HUANsic/ICAR_Hover2024/CH32Code/iomap.pptx

CH32V307

## Slide 2

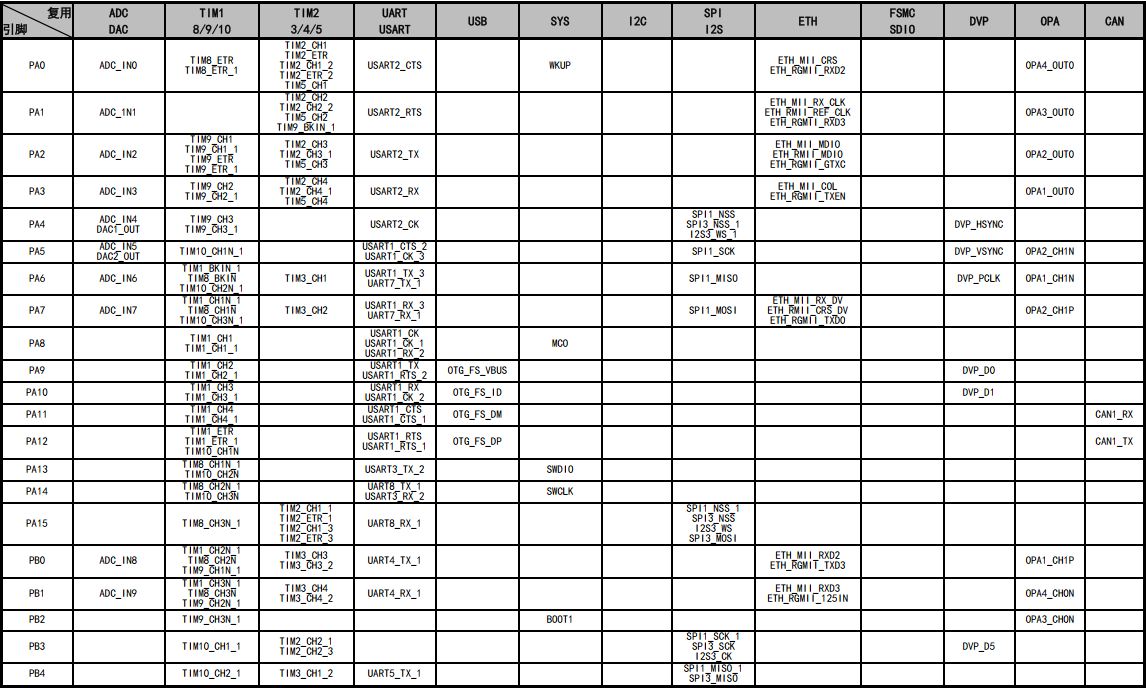
[picture p1: figure]

## Slide 3

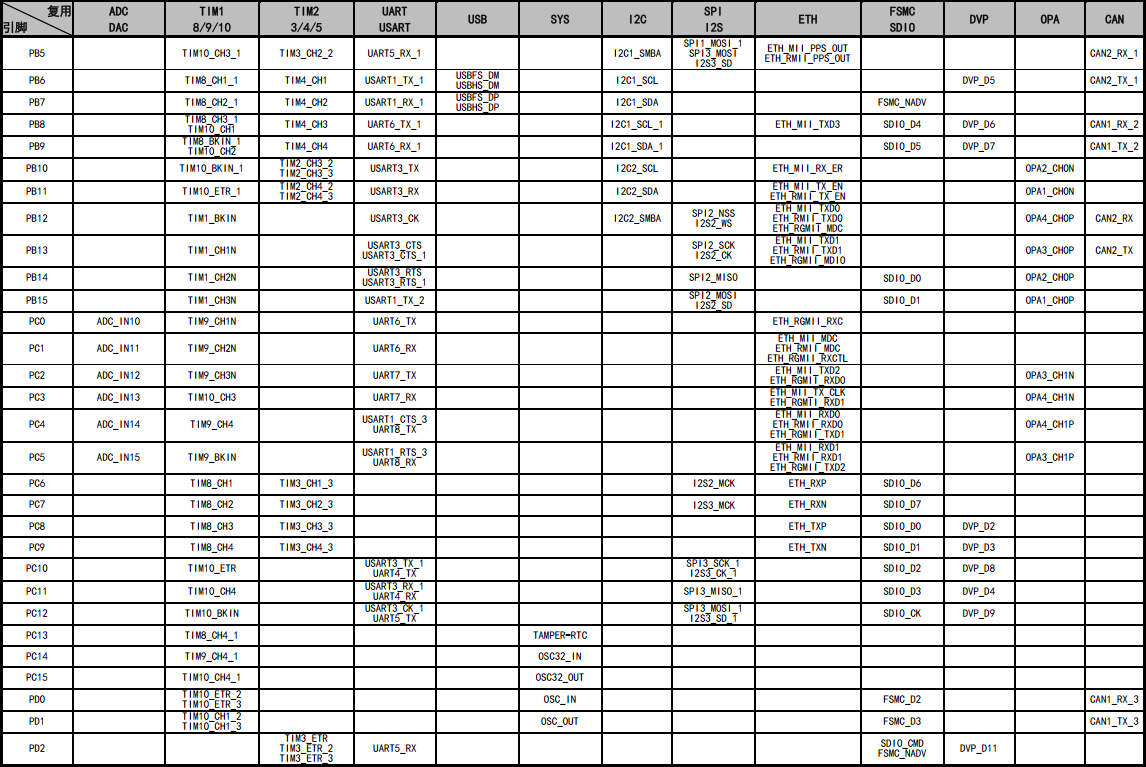
[picture p2: figure]

## Slide 4

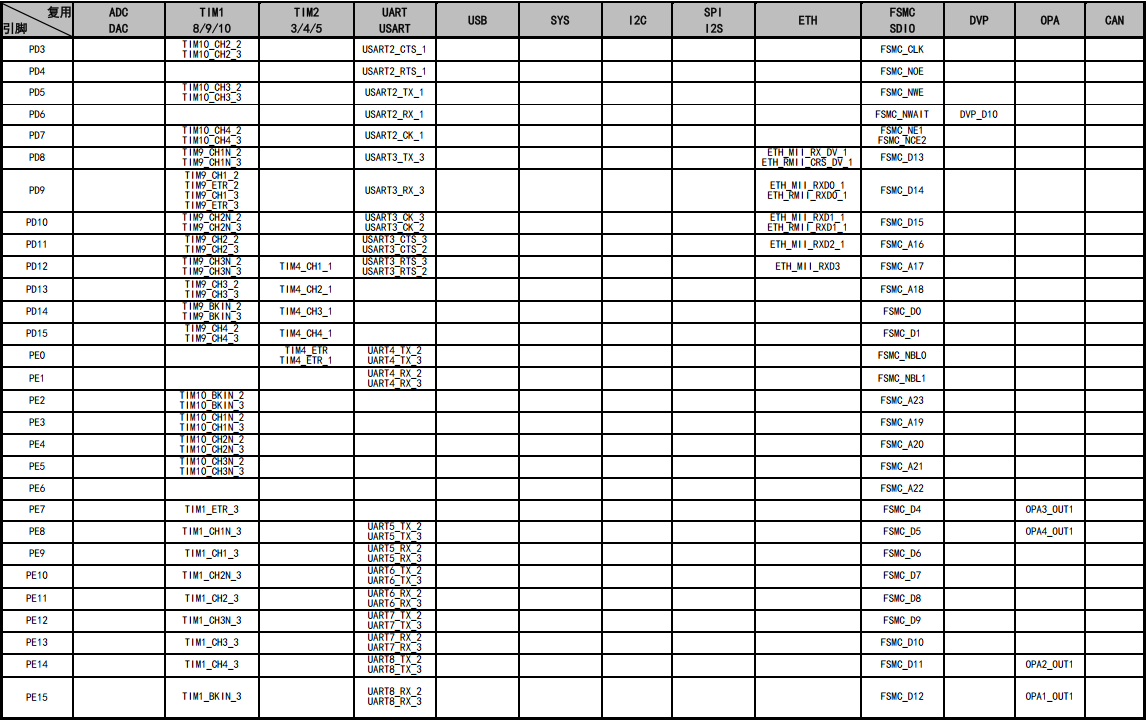
[picture p3: figure]

## Slide 5

CH32V203

## Slide 6

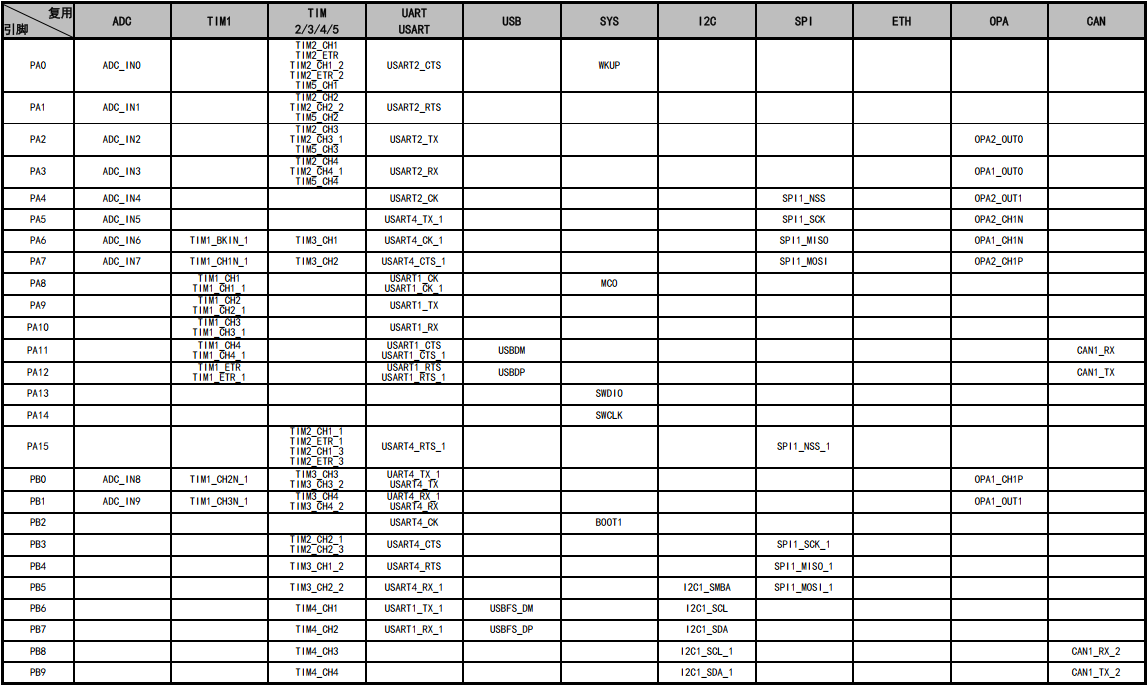
[picture p4: figure]

## Slide 7

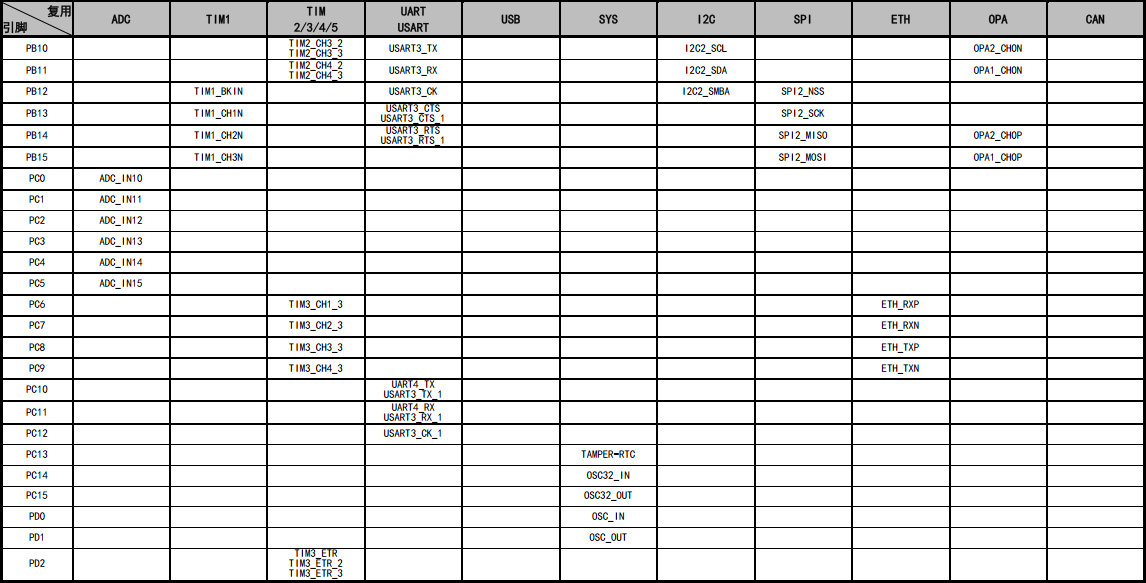
[picture p5: figure]

## Slide 8
