HUANsic/ICAR_Hover2024/PCB/version3/嘉立创SMT订单核对_Gerber_Main_v3_2024-07-28_2024-7-28.pdf

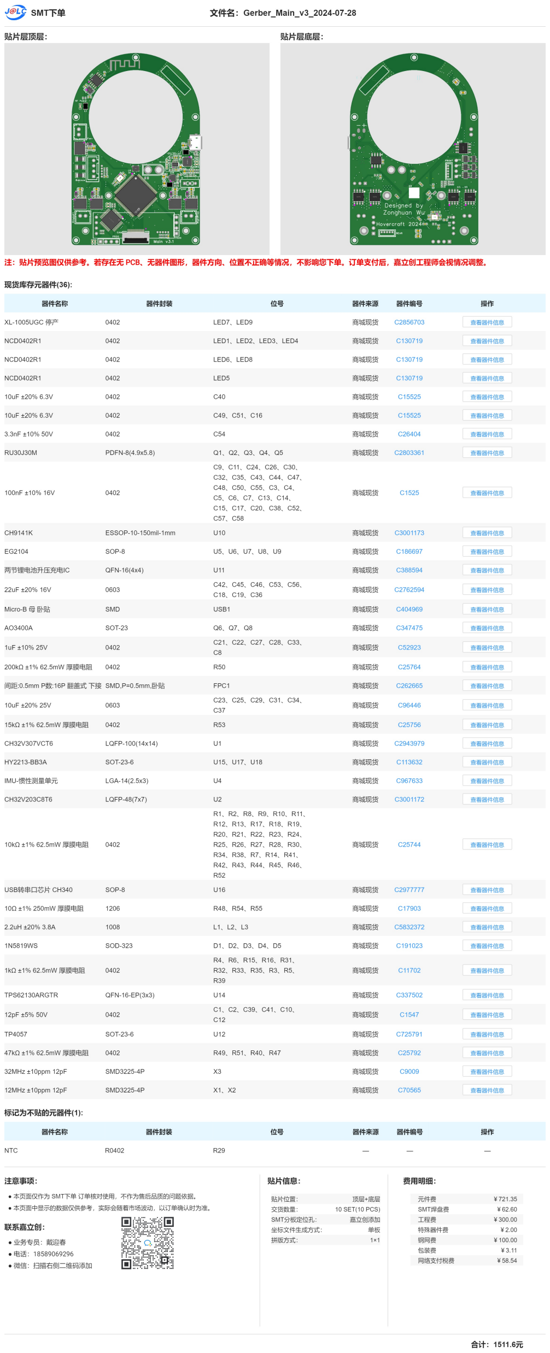
[picture p6: page 1]
