HUANsic/ICAR_Hover2024/PCB/version3/BOM_Main_v3_Main_v3_2024-07-28.xlsx

No. | Quantity | Comment | Designator | Footprint | Value | Manufacturer Part | Manufacturer | Supplier Part | Supplier
1 | 6 | 12pF | C1,C2,C10,C12,C39,C41 | C0402 | 12pF | 0402CG120J500NT | FH(风华) | C1547 | LCSC
2 | 27 | 100nF | C3,C4,C5,C6,C7,C9,C11,C13,C14,C15,C17,C20,C24,C26,C30,C32,C35,C38,C43,C44,C47,C48,C50,C52,C55,C57,C58 | C0402 | 100nF | CL05B104KO5NNNC | SAMSUNG(三星) | C1525 | LCSC
3 | 6 | 1uF | C8,C21,C22,C27,C28,C33 | C0402 | 1uF | CL05A105KA5NQNC | SAMSUNG(三星) | C52923 | LCSC
4 | 3 | 10uF | C16,C49,C51 | C0402 | 10uF | CL05A106MQ5NUNC | SAMSUNG(三星) | C15525 | LCSC
5 | 8 | 22uF | C18,C19,C36,C42,C45,C46,C53,C56 | C0603 | 22uF | CL10A226MO7JZNC | SAMSUNG(三星) | C2762594 | LCSC
6 | 6 | 10uF | C23,C25,C29,C31,C34,C37 | C0603 | 10uF | CL10A106MA8NRNC | SAMSUNG(三星) | C96446 | LCSC
7 | 1 | 2.2uF | C40 | C0402 | 2.2uF | CL05A225MQ5NSNC | SAMSUNG(三星) | C12530 | LCSC
8 | 1 | 3.3nF | C54 | C0402 | 3.3nF | CL05B332KB5NNNC | SAMSUNG(三星) | C26404 | LCSC
9 | 5 | 1N5819WS | D1,D2,D3,D4,D5 | SOD-323_L1.8-W1.3-LS2.5-RD |  | 1N5819WS | Hottech(合科泰) | C191023 | LCSC
10 | 1 | CAM | FPC1 | FPC-SMD_P0.50-16P_FGS-XJ-H2.0 |  | AFC01-S16FCA-00 | JS(钜硕电子) | C262665 | LCSC
11 | 3 | 2.2uH | L1,L2,L3 | IND-SMD_L2.5-W2.0_MHCHL2520 | 2.2uH | FTC252012S2R2MBCA | cjiang(长江微电) | C5832372 | LCSC
12 | 4 | NCD0402R1 | LED1,LED2,LED3,LED4 | LED0402-RD |  | NCD0402R1 | 国星光电 | C130719 | LCSC
13 | 1 | RF Power | LED5 | LED0402-R-RD_RED |  | XL-1005SURC | XINGLIGHT(成兴光) | C965790 | LCSC
14 | 2 | CHRG | LED6,LED8 | LED0402-RD |  | NCD0402R1 | 国星光电 | C130719 | LCSC
15 | 2 | STBY | LED7,LED9 | LED0402-RD_GREEN |  | XL-1005UGC | XINGLIGHT(成兴光) | C2856703 | LCSC
16 | 5 | RU30J30M | Q1,Q2,Q3,Q4,Q5 | PDFN-8_L5.8-W4.9_RU30J30M |  | RU30J30M | Ruichips(锐骏半导体) | C2803361 | LCSC
17 | 3 | AO3400A | Q6,Q7,Q8 | SOT-23-3_L2.9-W1.3-P1.90-LS2.4-BR |  | AO3400A | UMW(友台半导体) | C347475 | LCSC
18 | 32 | 10kΩ | R1,R2,R7,R8,R9,R10,R11,R12,R13,R14,R17,R18,R19,R20,R21,R22,R23,R24,R25,R26,R27,R28,R30,R34,R38,R41,R42,R43,R44,R45,R46,R52 | R0402 | 10kΩ | 0402WGF1002TCE | UNI-ROYAL(厚声) | C25744 | LCSC
19 | 11 | 1kΩ | R3,R4,R5,R6,R15,R16,R31,R32,R33,R35,R39 | R0402 | 1kΩ | 0402WGF1001TCE | UNI-ROYAL(厚声) | C11702 | LCSC
20 | 1 | NTC | R29 | R0402 | NTCThermistor | NCP15XH103F03RC | muRata(村田) | C77131 | LCSC
21 | 4 | 47kΩ | R40,R47,R49,R51 | R0402 | 47kΩ | 0402WGF4702TCE | UNI-ROYAL(厚声) | C25792 | LCSC
22 | 3 | 10Ω | R48,R54,R55 | R1206 | 10Ω | 1206W4F100JT5E | UNI-ROYAL(厚声) | C17903 | LCSC
23 | 1 | 200kΩ | R50 | R0402 | 200kΩ | 0402WGF2003TCE | UNI-ROYAL(厚声) | C25764 | LCSC
24 | 1 | 15kΩ | R53 | R0402 | 15kΩ | 0402WGF1502TCE | UNI-ROYAL(厚声) | C25756 | LCSC
25 | 1 | CH32V307VCT6 | U1 | LQFP-100_L14.0-W14.0-P0.50-LS16.0-BL |  | CH32V307VCT6 | WCH(南京沁恒) | C2943979 | LCSC
26 | 1 | CH32V203C8T6 | U2 | LQFP-48_L7.0-W7.0-P0.50-LS9.0-BL |  | CH32V203C8T6 | WCH(南京沁恒) | C3001172 | LCSC
27 | 1 | LSM6DS3TR-C | U4 | LGA-14_L3.0-W2.5-P0.50-TL |  | LSM6DS3TR-C | ST(意法半导体) | C967633 | LCSC
28 | 5 | EG2104 | U5,U6,U7,U8,U9 | SOP-8_L5.0-W4.0-P1.27-LS6.2-BL |  | EG2104 | EG(屹晶微) | C186697 | LCSC
29 | 1 | CH9141K | U10 | SSOP-10_L5.0-W3.9-P1.00-LS6.0-BL-EP |  | CH9141K | WCH(南京沁恒) | C3001173 | LCSC
30 | 1 | SLM6800 | U11 | VQFN-16_L4.0-W4.0-P0.65-TL-EP2.2 |  | SLM6800 | 无锡松朗微 | C388594 | LCSC
31 | 1 | TP4057 | U12 | SOT-23-6_L2.9-W1.6-P0.95-LS2.8-BR |  | TP4057 | UMW(友台半导体) | C725791 | LCSC
32 | 1 | TPS62130ARGTR | U14 | VQFN-16_L3.0-W3.0-P0.50-BL-EP1.7 |  | TPS62130ARGTR | TI(德州仪器) | C337502 | LCSC
33 | 3 | HY2213-BB3A | U15,U17,U18 | SOT-23-6_L2.9-W1.6-P0.95-LS2.8-BR |  | HY2213-BB3A | HYCON(宏康) | C113632 | LCSC
34 | 1 | CH340N | U16 | SOP-8_L4.9-W3.9-P1.27-LS6.0-BL |  | CH340N | WCH(南京沁恒) | C2977777 | LCSC
35 | 1 | MicroXNJ | USB1 | MICRO-USB-SMD_MICROXNJ |  | MicroXNJ | SHOU HAN(首韩) | C404969 | LCSC
36 | 2 | 12MHz | X1,X2 | OSC-SMD_4P-L3.2-W2.5-BL | 12MHz | X322512MOB4SI | YXC(扬兴晶振) | C70565 | LCSC
37 | 1 | 32MHz | X3 | CRYSTAL-SMD_4P-L3.2-W2.5-BL | 32MHz | X322532MOB4SI | YXC(扬兴晶振) | C9009 | LCSC
