HUANsic/ICAR_Hover2024/Solidworks/version3/CameraBase_5.STL

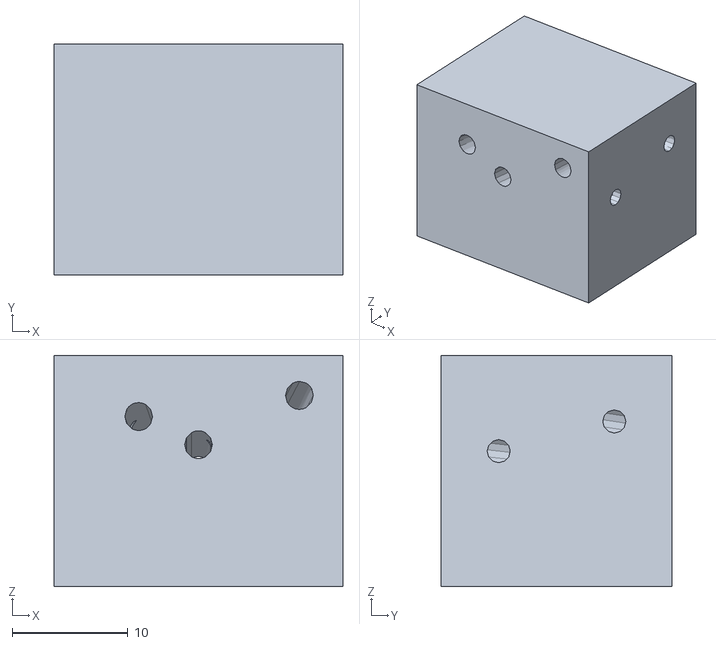
[picture p7: CAD file, 2024-08-02]
Solidworks/version3/CameraBase_5.STL
25.0 x 20.0 x 20.0
