HUANsic/ICAR_Hover2024/Solidworks/version3/CF_stick_2x1x300.SLDPRT

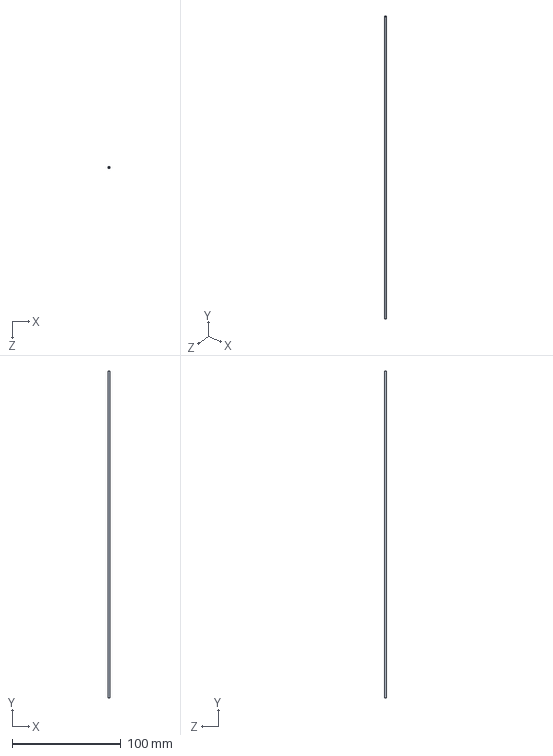
[picture p8: CAD file, 2024-08-02]
Solidworks/version3/CF_stick_2x1x300.SLDPRT
2.00 x 300.0 x 2.00 mm
