HUANsic/ICAR_Hover2024/Solidworks/version3/CameraClip_1mm.SLDPRT

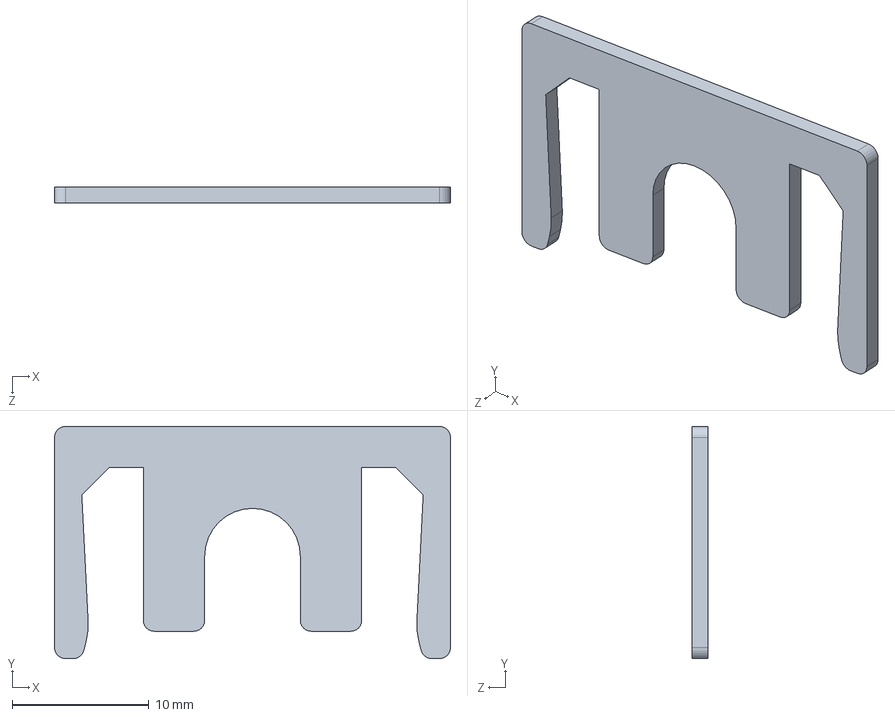
[picture p10: CAD file, 2024-08-02]
Solidworks/version3/CameraClip_1mm.SLDPRT
29.0 x 17.0 x 1.20 mm
