HUANsic/ICAR_Hover2024/Solidworks/version3/CameraBase_7.STL

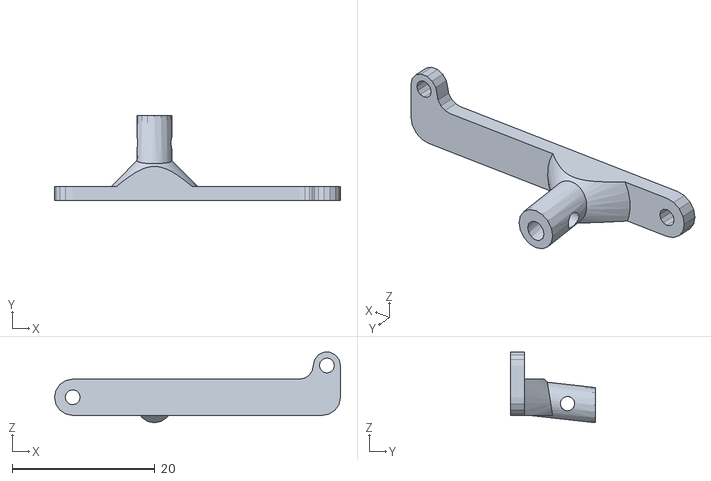
[picture p11: CAD file, 2024-08-02]
Solidworks/version3/CameraBase_7.STL
40.0 x 11.9 x 9.87
