HUANsic/ICAR_Hover2024/Solidworks/version3/propeller_1608.SLDPRT

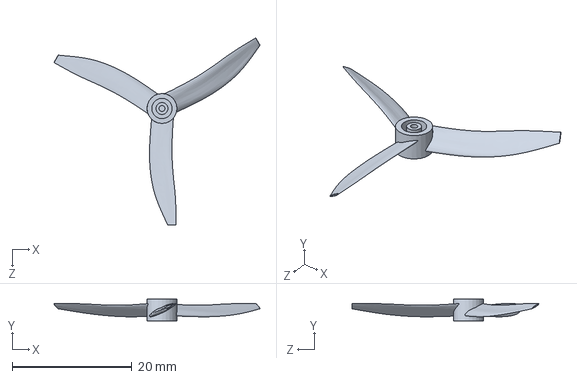
[picture p12: CAD file, 2024-08-02]
Solidworks/version3/propeller_1608.SLDPRT
34.5 x 3.60 x 31.3 mm
