HUANsic/ICAR_Hover2024/Solidworks/version3/CameraBase_6.STL

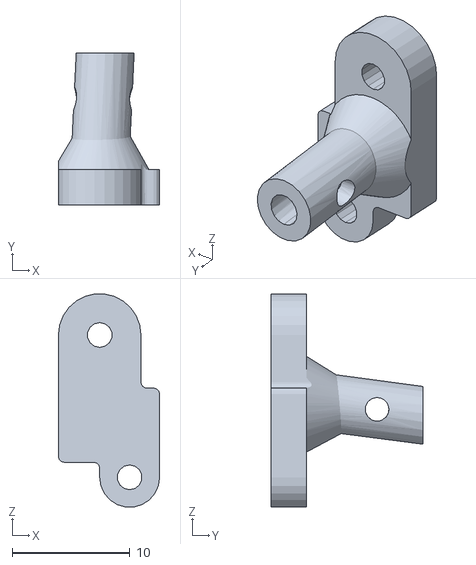
[picture p13: CAD file, 2024-08-02]
Solidworks/version3/CameraBase_6.STL
8.58 x 12.9 x 18.1
