HUANsic/ICAR_Hover2024/Solidworks/version3/PropHolder1.SLDPRT

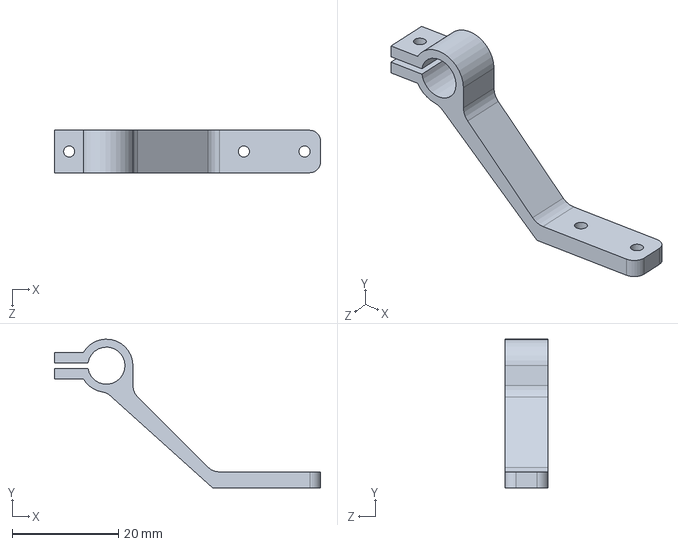
[picture p14: CAD file, 2024-08-02]
Solidworks/version3/PropHolder1.SLDPRT
50.1 x 28.0 x 8.00 mm
