HUANsic/ICAR_Hover2024/Solidworks/version3/CameraBase_4.STL

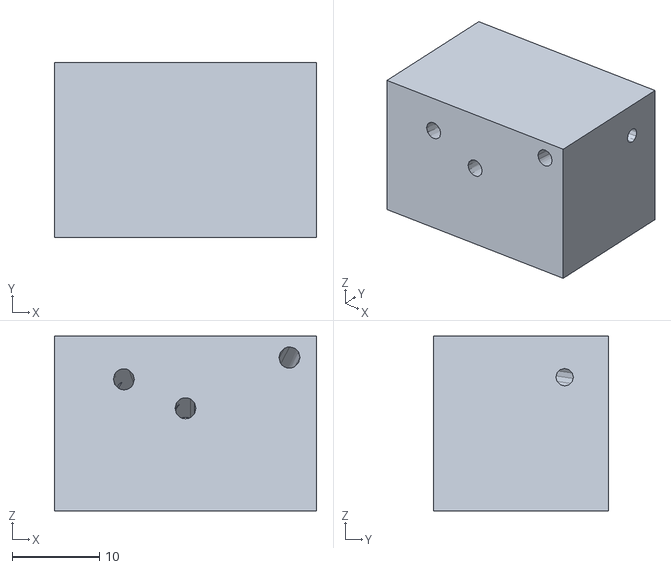
[picture p16: CAD file, 2024-08-02]
Solidworks/version3/CameraBase_4.STL
30.0 x 20.0 x 20.0
