HUANsic/ICAR_Hover2024/Solidworks/version3/CameraBase_9_w_clip.STL

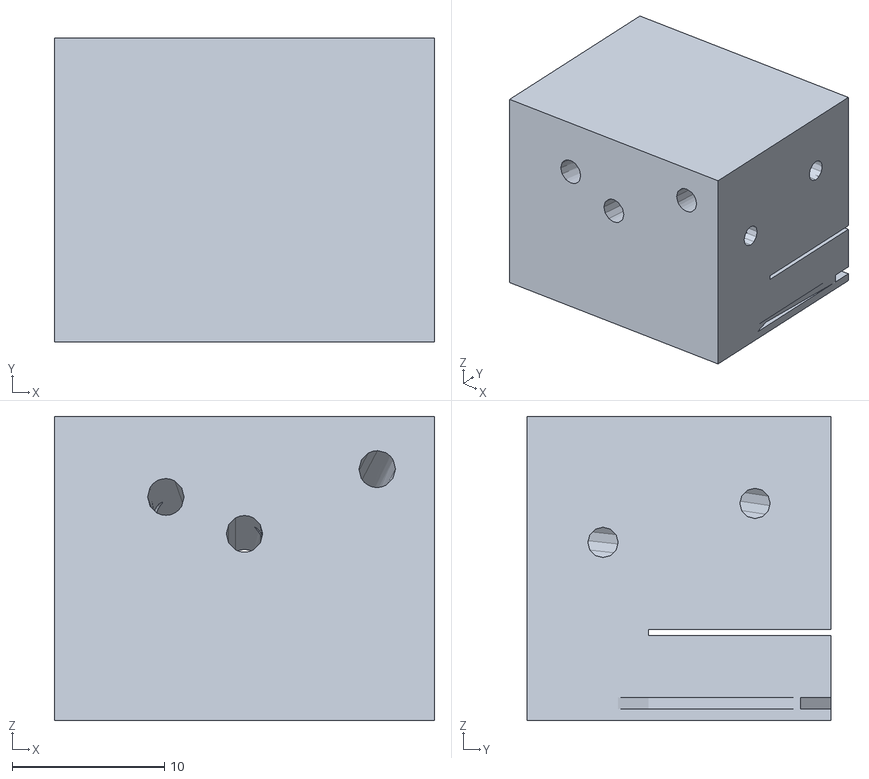
[picture p17: CAD file, 2024-08-02]
Solidworks/version3/CameraBase_9_w_clip.STL
25.0 x 20.0 x 20.0
