HUANsic/ICAR_Hover2024/Solidworks/version3/CameraBase_8.STL

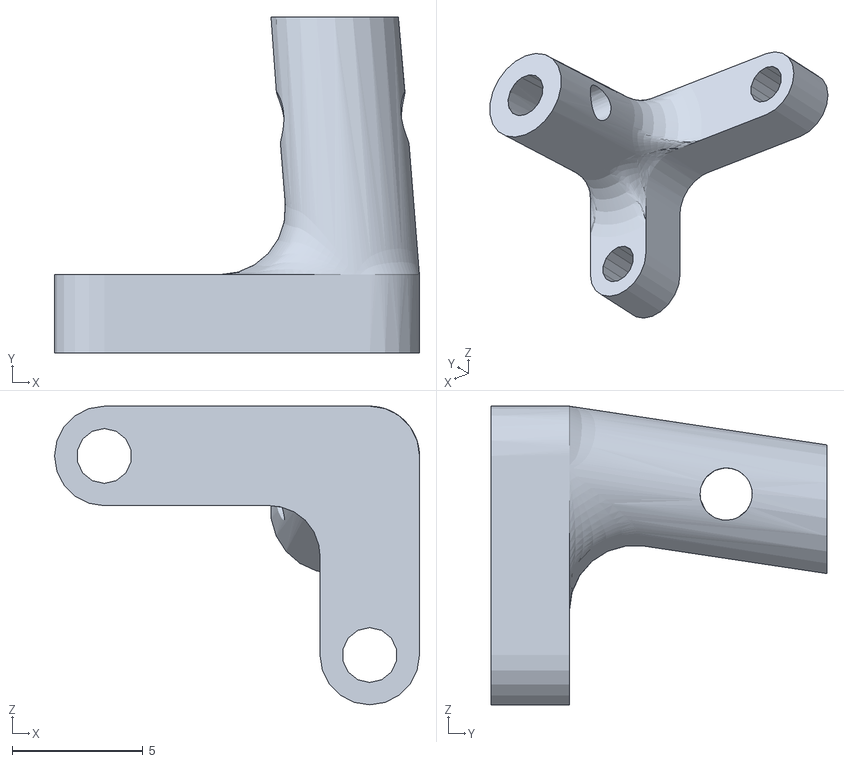
[picture p18: CAD file, 2024-08-02]
Solidworks/version3/CameraBase_8.STL
14.0 x 12.9 x 11.4
