HUANsic/ICAR_Hover2024/Solidworks/version3/base.SLDPRT

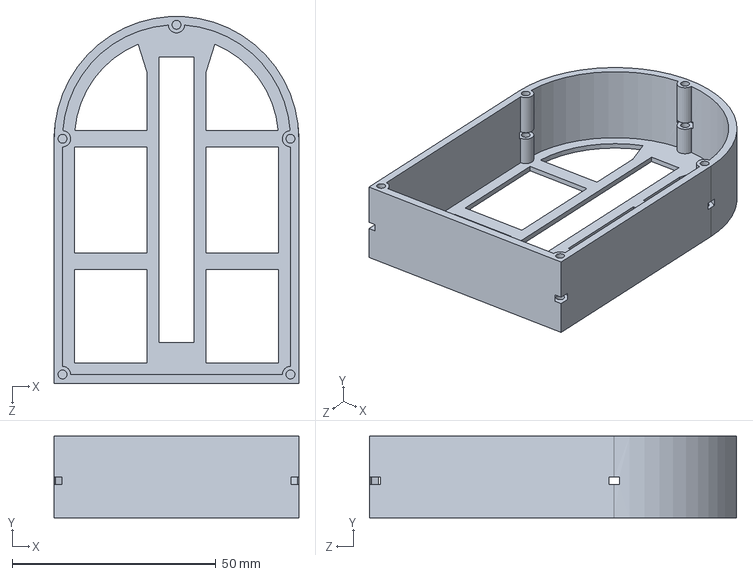
[picture p19: CAD file, 2024-08-02]
Solidworks/version3/base.SLDPRT
60.0 x 20.0 x 90.0 mm
