HUANsic/ICAR_Hover2024/Solidworks/version3/CameraBase.SLDPRT

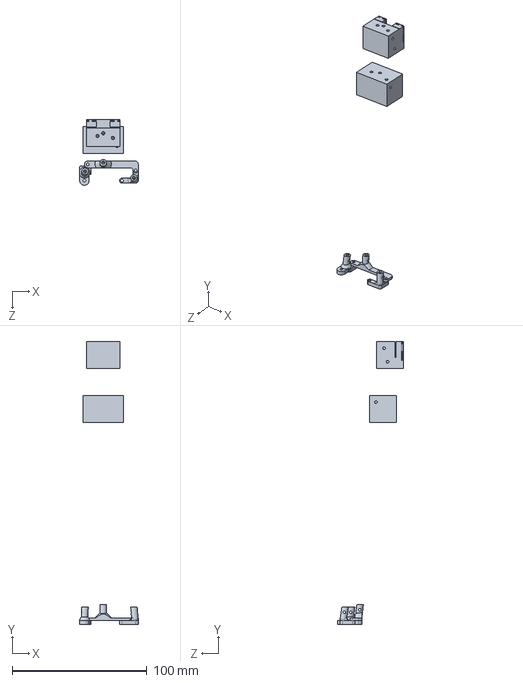
[picture p21: CAD file, 2024-08-02]
Solidworks/version3/CameraBase.SLDPRT
43.5 x 210.0 x 48.7 mm
