HUANsic/ICAR_Hover2024/Solidworks/version3/support_10mm.SLDPRT

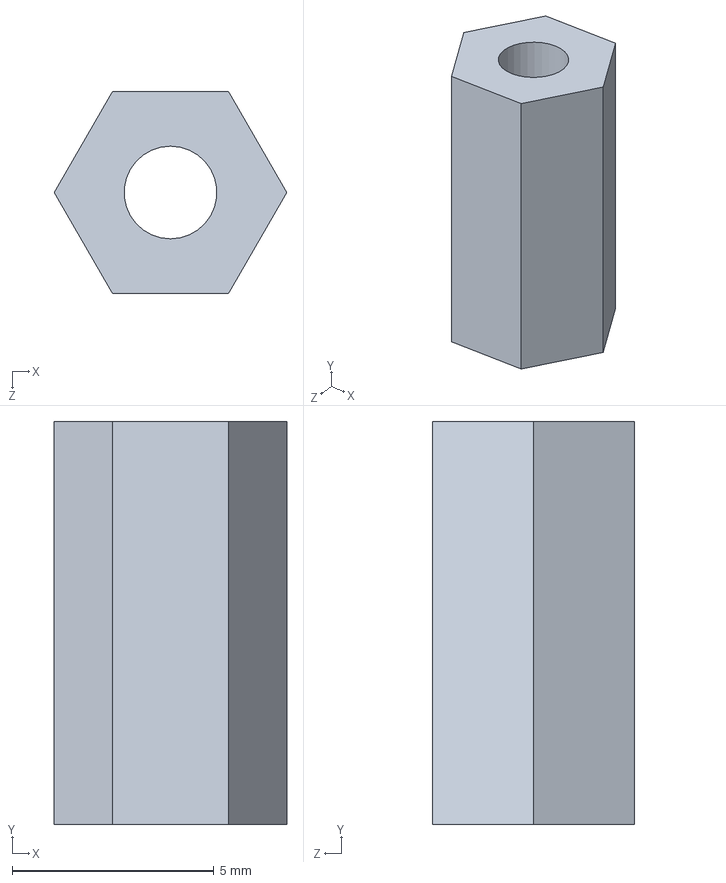
[picture p23: CAD file, 2024-08-02]
Solidworks/version3/support_10mm.SLDPRT
5.77 x 10.0 x 5.00 mm
