HUANsic/ICAR_Hover2024/Solidworks/version3/FanHolder.SLDPRT

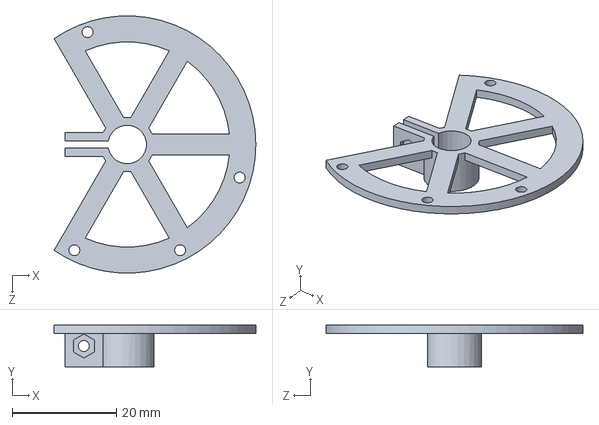
[picture p24: CAD file, 2024-08-02]
Solidworks/version3/FanHolder.SLDPRT
38.8 x 8.00 x 49.4 mm
