HUANsic/ICAR_Hover2024/Solidworks/version3/CF_stick_2x1x240.SLDPRT

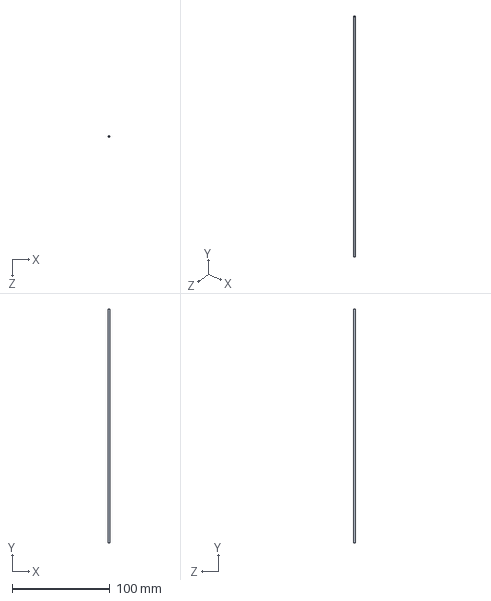
[picture p25: CAD file, 2024-08-02]
Solidworks/version3/CF_stick_2x1x240.SLDPRT
2.00 x 240.0 x 2.00 mm
