HUANsic/ICAR_Hover2024/Solidworks/version3/716_1mm.SLDPRT

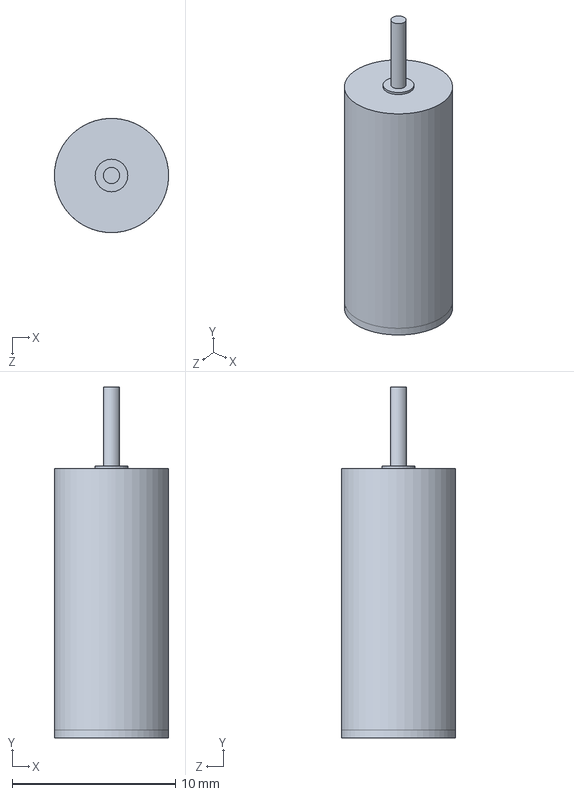
[picture p26: CAD file, 2024-08-02]
Solidworks/version3/716_1mm.SLDPRT
7.00 x 21.5 x 7.00 mm
