HUANsic/ICAR_Hover2024/(list of files, cad)

Other CAD files:
Solidworks/version3/camera_batch4.gcode.3mf
Solidworks/version3/CameraClip_0mm5.SLDPRT
Solidworks/version3/CameraClip.SLDPRT
Solidworks/version3/camera_batch1.gcode.3mf
Solidworks/version3/camera_batch5_w_clip.gcode.3mf
Solidworks/version3/camera_batch2.gcode.3mf
Solidworks/version3/camera_batch3.gcode.3mf
Solidworks/version3/CameraBase_2.STL
Solidworks/version3/prop1.gcode.3mf
Solidworks/version3/fan1.gcode.3mf
Solidworks/version3/support10mm.gcode.3mf
Solidworks/version1/3D_MiniDriver_2024-01-19.SLDPRT
Solidworks/version1/3D_MiniDriver_2024-01-19.step
Solidworks/version1/Battery_322006.SLDPRT
Solidworks/version1/Battery_372006.SLDPRT
Solidworks/version1/Battery_372008.SLDPRT
Solidworks/version1/IC_Card.SLDPRT
Solidworks/version1/MotorHolder_716.SLDPRT
Solidworks/version1/MotorHolder_716_Left.SLDPRT
Solidworks/version1/MotorHolder_716_Right.SLDPRT
Solidworks/version1/Motor_610_08mm.SLDPRT
Solidworks/version1/Motor_614_08mm.SLDPRT
Solidworks/version1/Motor_716_08mm.SLDPRT
Solidworks/version1/Motor_716_1mm.SLDPRT
Solidworks/version1/Motor_8520_1mm.SLDPRT
Solidworks/version1/Prop_1220-4_31mm.SLDPRT
Solidworks/version1/Prop_1608-3_40mm.SLDPRT
Solidworks/version1/Reflector.SLDPRT
Solidworks/version1/base.SLDPRT
Solidworks/version1/base.STL
Solidworks/version1/base_withClipLine.STL
Solidworks/version1/base_withClips.STL
Solidworks/version1/base_withHoles.STL
Solidworks/version1/clip.SLDPRT
Solidworks/version1/clip.STL
Solidworks/version1/clip_side.SLDPRT
Solidworks/version2/COMPOUND-14.step.SLDPRT
Solidworks/version2/base_v2.SLDPRT
Solidworks/version2/base_v2.STL
Solidworks/version2/lid_v2.SLDPRT
Solidworks/version3/CameraClip_0mm.STL
Solidworks/version3/CameraClip_0mm5.STL
Solidworks/version3/CameraClip_1mm.STL
Solidworks/version3/CameraClip_1mm5.STL
Solidworks/version3/CameraClip_2mm.STL
Solidworks/version3/FanHolder.STL
Solidworks/version3/PropHolder1.STL
Solidworks/version3/base.STL
Solidworks/version3/support_10mm.STL
