HUANsic/ICAR_Hover2024/PCB/version2/PCB_Main_v2_2024-06-27.pdf

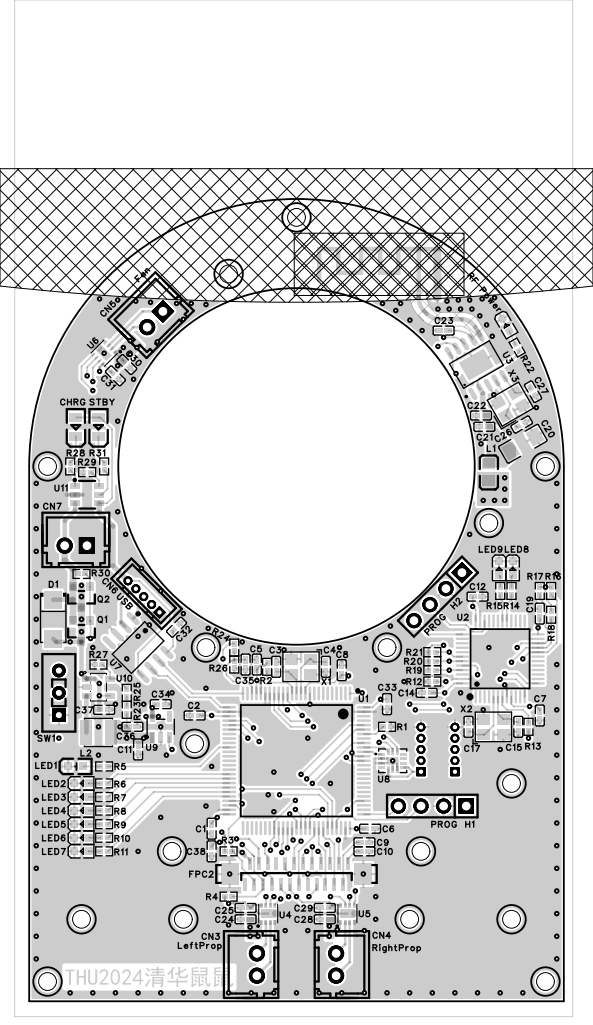
[picture p34: page 1]

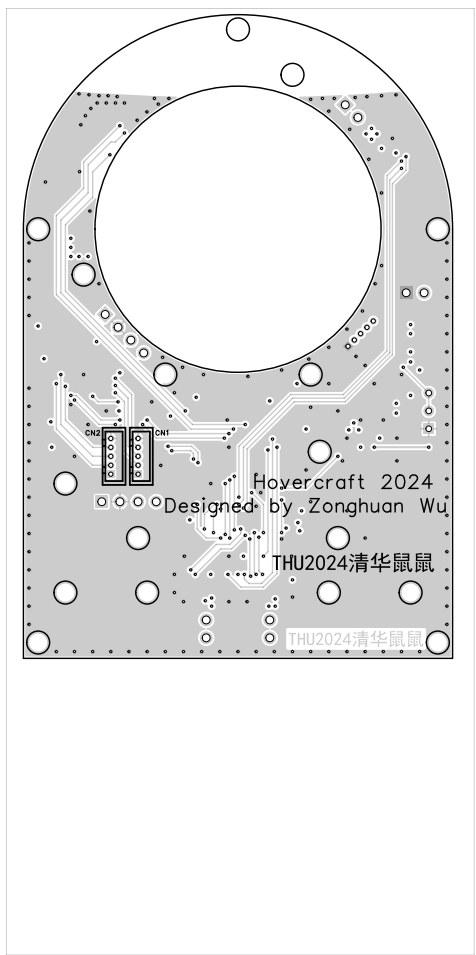
[picture p35: page 2]

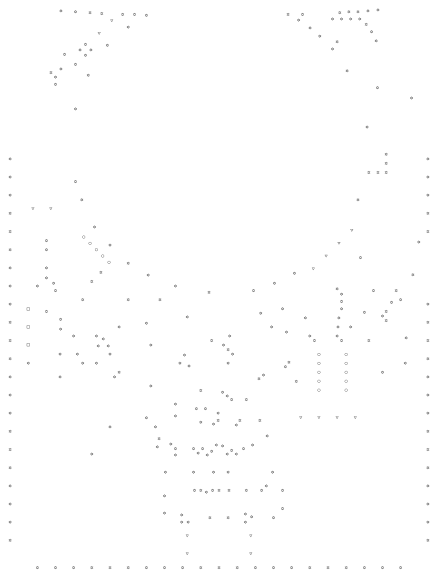
[picture p36: page 3]
