HUANsic/ICAR_Hover2024/PCB/version2/SCH_Main_v2_2024-06-27.pdf

VIO_1 50 PB12 51 PB13 52 PB14 53 PB15 54 PD8 55 PD9 56 PD10 57 PD11 58 PD12 59 PD13 60 PD14 61 PD15 62 PC6/RXP 63 PC7/RXN 64 PC8/TXP 65 PC9/TXN 66 PA8 67 PA9 68 PA10 69 PA11/USB1DM 70 PA12/USB1DP 71 PA13/SWDIO 72 NC 73 VSS_2 74 VDD_2 75 PA14/SWCLK 76 PA15 77 PC10 78 PC11 79 PC12 80 PD0 81 PD1 82 PD2 83 PD3 84 PD4 85 PD5 86 PD6 87 PD7 88 PB3 89 PB4 90 PB5 91 PB6/USB2DM 92 PB7/USB2DP 93 BOOT0 94 PB8 95 PB9 96 PE0 97 PE1 98 VSS_3 99 VIO_3 100

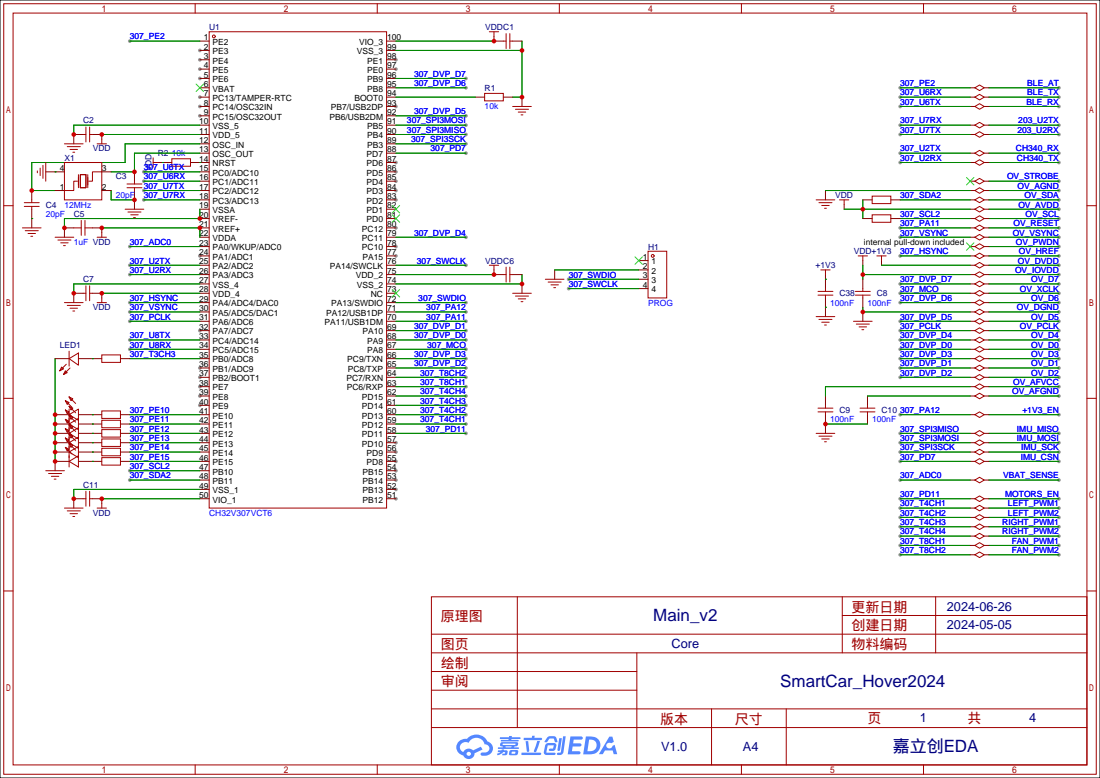
[picture p37: page 1]

internal pull-down included
VDD+1V3

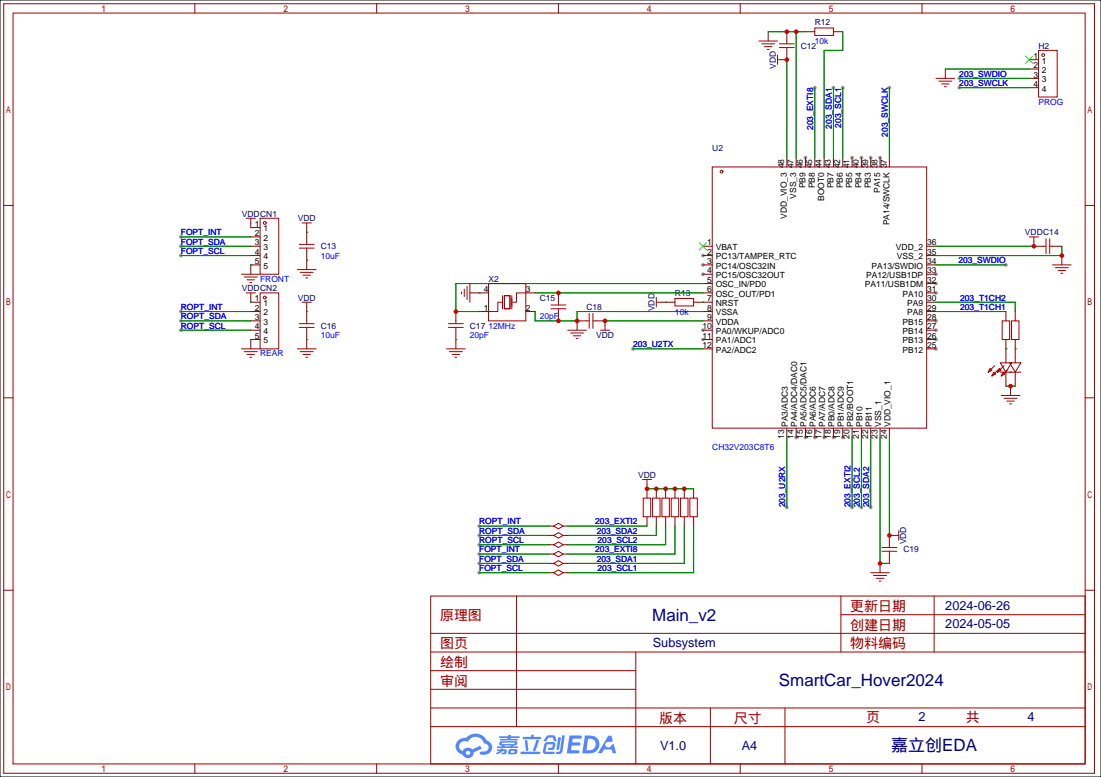
[picture p38: page 2]

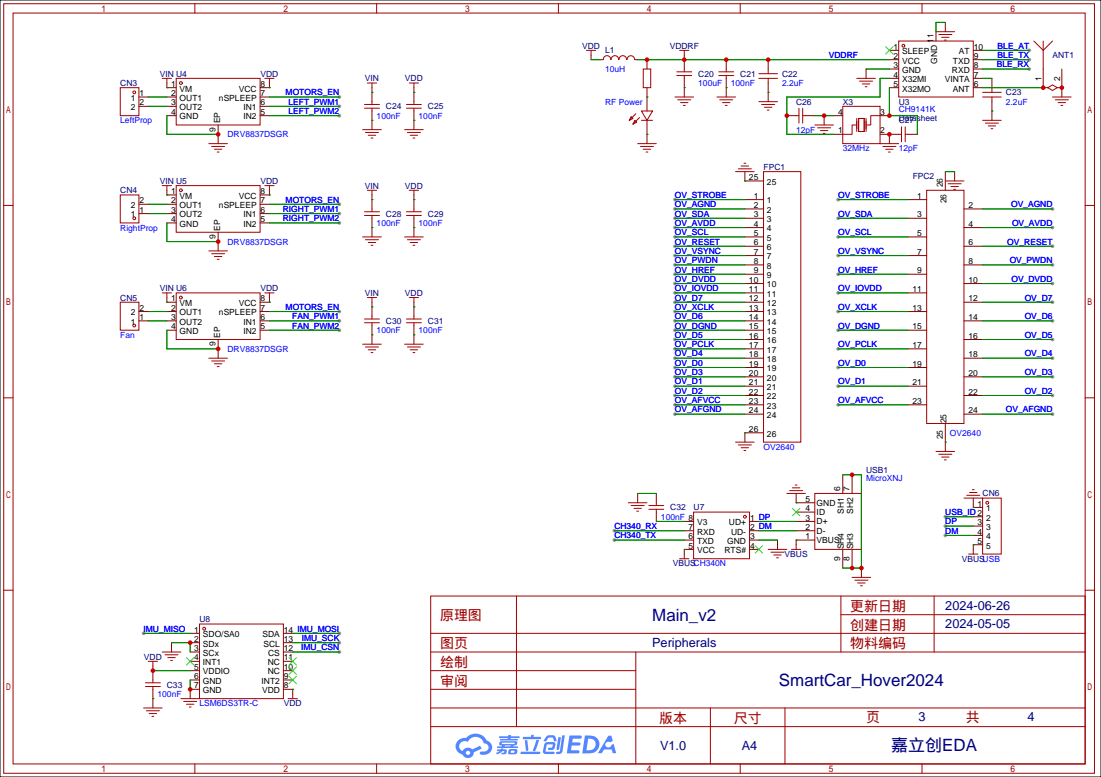
[picture p39: page 3]

NC 10 NC 11 CS 12 SCL 13 SDA 14

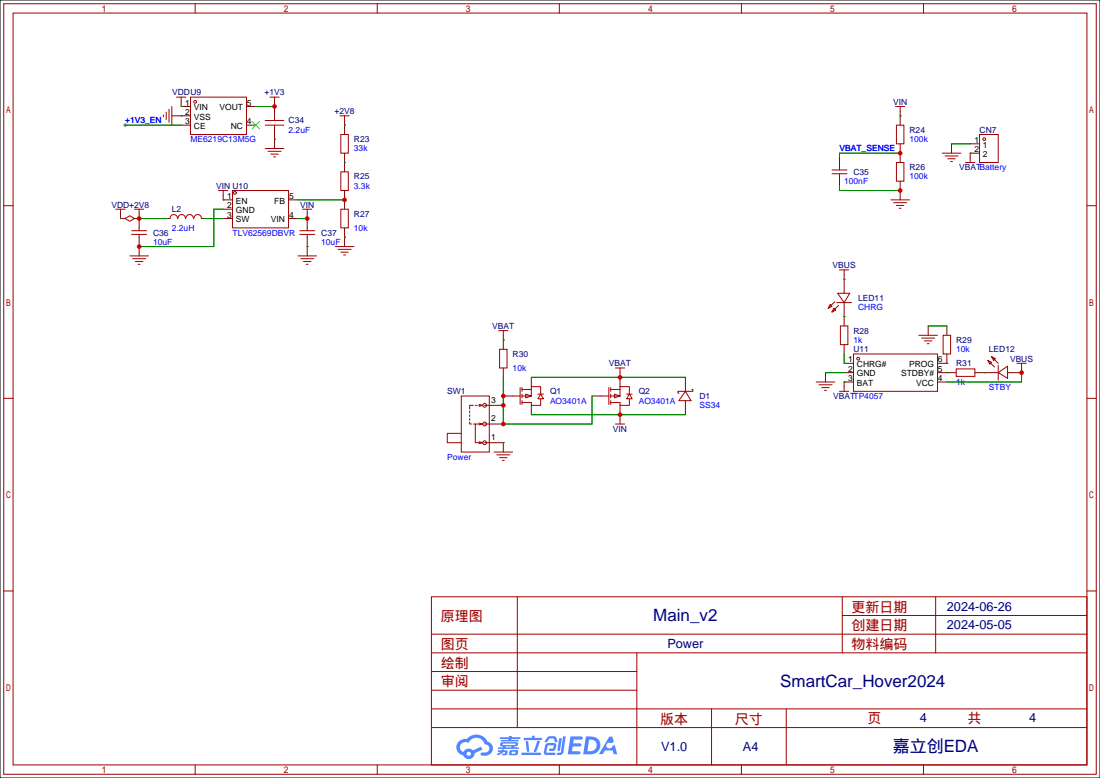
[picture p40: page 4]
