HUANsic/ICAR_Hover2024/CH32Code/ICAR_Hover2024_V3_Master/User/main.c

/********************************** (C) COPYRIGHT *******************************
 * File Name          : main.c
 * Author             : WCH
 * Version            : V1.0.0
 * Date               : 2021/06/06
 * Description        : Main program body.
 *********************************************************************************
 * Copyright (c) 2021 Nanjing Qinheng Microelectronics Co., Ltd.
 * Attention: This software (modified or not) and binary are used for
 * microcontroller manufactured by Nanjing Qinheng Microelectronics.
 *******************************************************************************/

/*
 *@Note
 USART Print debugging routine:
 USART1_Tx(PA9).
 This example demonstrates using USART1(PA9) as a print debug port output.

 */

#include "huansic_utility.h"

/* Global typedef */

/* Global define */

/* Global Variable */

/*********************************************************************
 * @fn      main
 *
 * @brief   Main program.
 *
 * @return  none
 */
int main(void)
{
	NVIC_PriorityGroupConfig(NVIC_PriorityGroup_2);
	Utility_Init();
	Utility_Time_DelayUs(100);

	while(1) {
		Utility_LED_Set(LED1, 0.1);
//		Utility_Time_DelayMs(500);
		Utility_Time_DelayUs(500000);
		Utility_LED_Set(LED1, 0.9);
//		Utility_Time_DelayMs(500);
		Utility_Time_DelayUs(500000);
	}
}
