HUANsic/ICAR_Hover2024/CH32Code/ICAR_Hover2024_V203_Subsystem/User/huansic_chronos.c

/*
 * huansic_chronos.c
 *
 *  Created on: May 20, 2024
 *      Author: ZonghuanWu
 */

#include "huansic_chronos.h"

uint32_t seconds;
uint16_t milliseconds;

struct Reminder {
	uint32_t scheduled_second;
	uint16_t scheduled_ms;
	void (*thread)(uint32_t sec, uint16_t ms);
};

#define	REMINDER_LENGTH	32
struct Reminder reminders[REMINDER_LENGTH];
uint8_t wheel[REMINDER_LENGTH];		// will be set to 255 if there's no upcoming reminder
uint8_t next;
void (*fp)(uint32_t sec, uint16_t ms);

void __huansic_systick_update_irq(void) {
	if (milliseconds == 59) {
		seconds++;
		milliseconds = 0;
	} else {
		milliseconds++;
	}

	// push the wheel
	if (wheel[next] < REMINDER_LENGTH) {
		while (reminders[wheel[next]].scheduled_second >= seconds && reminders[wheel[next]].scheduled_ms >= milliseconds) {
			fp = reminders[wheel[next]].thread;		// store the function pointer
			// condition the reminder
			reminders[wheel[next]].thread = 0;
			reminders[wheel[next]].scheduled_second = 0;
			reminders[wheel[next]].scheduled_ms = 0;
			wheel[next] = 255;
			next = (next + 1) % REMINDER_LENGTH;
			// call the thread
			if (fp) {
				fp(seconds, milliseconds);}
		}
	}
}

void chronos_init(void) {
	uint8_t i;
	seconds = 0;
	milliseconds = 1;
	next = 0;
	for (i = 0; i < REMINDER_LENGTH; i++) {
		wheel[i] = 255;
		reminders[i].thread = 0;
		reminders[i].scheduled_second = 0;
		reminders[i].scheduled_ms = 0;
	}

	// clear status register and counter
	SysTick->SR = 0;
	SysTick->CNT = 0;
	// update every millisecond
	SysTick->CMP = SystemCoreClock / 1000 - 1;
	// start SysTick
	SysTick->CTLR = 0xF;
	// enable interrupt
	NVIC_SetPriority(SysTicK_IRQn, 1);
	NVIC_EnableIRQ(SysTicK_IRQn);
}

void huansic_delay_ms(uint16_t duration) {
	uint32_t start = seconds * 60 + milliseconds;
	while(seconds * 60 + milliseconds - start < duration);
}

void huansic_delay_us(uint16_t duration) {
	uint32_t temp = duration, i;
	temp *= SystemCoreClock / 1000000;	// total CPU cycles
	if (temp < 30)
		return;		// can't make it that precise, probably already elapsed
	temp -= 30;		// idk, feel like it
	temp /= 5;		// for loop count

	for (i = 0; i < temp; i++)
		;
}

uint32_t huansic_chronos_seconds() {
	return seconds;
}

uint32_t chronos_milliseconds() {
	return milliseconds;
}

int8_t chronos_schedule(uint32_t scheduled_second, uint16_t scheduled_ms, void (*thread)(uint32_t sec, uint16_t ms)) {
	// if time already elapsed, return -1
	if (scheduled_second > seconds || (scheduled_second == seconds && scheduled_ms >= milliseconds))
		return -1;

	// find a place to hold the information
	uint8_t i, target = 255, replc = 255, temp, holding;
	for (i = 0; i < REMINDER_LENGTH; i++) {
		if (!reminders[i].thread) {
			target = i;
			break;
		}
	}
	// if there's no place for it, return -2
	if (target == 255)
		return -2;

	// add the reminder
	reminders[target].scheduled_second = scheduled_second;
	reminders[target].scheduled_ms = scheduled_ms;
	reminders[target].thread = thread;

	// insert into the time wheel
	for (i = 0; i < REMINDER_LENGTH; i++) {
		// if it is empty
		if (wheel[(next + i) % REMINDER_LENGTH] == 255) {
			wheel[(next + i) % REMINDER_LENGTH] = target;
			return target;
		}

		// otherwise find the one to be inserted before
		if (reminders[wheel[(next + i) % REMINDER_LENGTH]].scheduled_second < scheduled_second)
			continue;
		if (reminders[wheel[(next + i) % REMINDER_LENGTH]].scheduled_second == scheduled_second)
			if (reminders[wheel[(next + i) % REMINDER_LENGTH]].scheduled_ms <= scheduled_ms)
				continue;
		replc = (next + i) % REMINDER_LENGTH;
	}
	if (replc == 255)
		return -3;
	// shift everything after it backwards
	i = 0;
	holding = target;
	while(holding != 255) {		// only break when an empty slot is replaced
		// if somehow it reached a loop, return -3
		if((replc + i) % REMINDER_LENGTH == next) {
			return -4;
		}

		// replace
		temp = wheel[(replc + i) % REMINDER_LENGTH];
		wheel[(replc + i) % REMINDER_LENGTH] = holding;
		holding = temp;
		i++;
	}

	// return index on success
	return target;
}
