HUANsic/ICAR_Hover2024/CH32Code/CH32V307VCT6_Serial/User/huansic_chronos.h

/*
 * huansic_chronos.h
 *
 *  Created on: May 20, 2024
 *      Author: ZonghuanWu
 */

#ifndef USER_HUANSIC_CHRONOS_H_
#define USER_HUANSIC_CHRONOS_H_

#include "ch32v30x.h"

void chronos_init(void);

void delay_ms(uint32_t duration);

void delay_us(uint16_t duration);

uint32_t chronos_milliseconds(void);

int8_t chronos_schedule(uint32_t scheduled_ms, void (*thread)(uint32_t ms));

#endif /* USER_HUANSIC_CHRONOS_H_ */
