HUANsic/ICAR_Hover2024/CH32Code/CH32V307VCT6_Serial/User/huansic_serial.h

/*
 * huansic_comm.h
 *
 *  Created on: May 21, 2024
 *      Author: ZonghuanWu
 */

#ifndef USER_HUANSIC_COMM_H_
#define USER_HUANSIC_COMM_H_

#include "ch32v30x.h"

void serial_init();

#endif /* USER_HUANSIC_COMM_H_ */
