HUANsic/ICAR_Hover2024/CH32Code/CH32V307VCT6_Serial/User/huansic_uitl.c

/*
 * huansic_uitl.c
 *
 *  Created on: May 21, 2024
 *      Author: ZonghuanWu
 */

#include "huansic_util.h"

void util_init() {
	// PWM pin
	GPIO_InitTypeDef GPIO_InitStructure = { 0 };
	TIM_OCInitTypeDef TIM_OCInitStructure = { 0 };
	TIM_TimeBaseInitTypeDef TIM_TimeBaseInitStructure = { 0 };

	RCC_APB2PeriphClockCmd(RCC_APB2Periph_GPIOB, ENABLE);
	RCC_APB1PeriphClockCmd(RCC_APB1Periph_TIM3, ENABLE);

	GPIO_InitStructure.GPIO_Pin = GPIO_Pin_0;
	GPIO_InitStructure.GPIO_Mode = GPIO_Mode_AF_PP;
	GPIO_InitStructure.GPIO_Speed = GPIO_Speed_50MHz;
	GPIO_Init( GPIOB, &GPIO_InitStructure);

	TIM_TimeBaseInitStructure.TIM_Period = 1000 - 1;
	TIM_TimeBaseInitStructure.TIM_Prescaler = SystemCoreClock / 1000 - 1;
	TIM_TimeBaseInitStructure.TIM_ClockDivision = TIM_CKD_DIV1;
	TIM_TimeBaseInitStructure.TIM_CounterMode = TIM_CounterMode_Up;
	TIM_TimeBaseInit( TIM3, &TIM_TimeBaseInitStructure);

	TIM_OCInitStructure.TIM_OCMode = TIM_OCMode_PWM1;
	TIM_OCInitStructure.TIM_OutputState = TIM_OutputState_Enable;
	TIM_OCInitStructure.TIM_Pulse = 0;	// turn off for now
	TIM_OCInitStructure.TIM_OCPolarity = TIM_OCPolarity_High;
	TIM_OC3Init( TIM3, &TIM_OCInitStructure);

	TIM_CtrlPWMOutputs(TIM3, ENABLE);
	TIM_OC3PreloadConfig( TIM3, TIM_OCPreload_Disable);
	TIM_ARRPreloadConfig( TIM3, ENABLE);
	TIM_Cmd( TIM3, ENABLE);

	// GPIO
	RCC_APB2PeriphClockCmd( RCC_APB2Periph_GPIOE, ENABLE);
	GPIO_InitStructure.GPIO_Mode = GPIO_Mode_Out_PP;
	GPIO_InitStructure.GPIO_Speed = GPIO_Speed_50MHz;
	GPIO_InitStructure.GPIO_Pin = 0xFC00;		// PE10~15
	GPIO_Init(GPIOE, &GPIO_InitStructure);

	// turn off for now
	GPIO_WriteBit(GPIOE, 0xFC00, Bit_RESET);
}

void util_led_set(LED_Typedef led, float bri) {
	if (led & LED1) {
		bri = bri > 1 ? 1 : (bri < 0 ? 0 : bri);
		TIM3->CH3CVR = (uint16_t) (bri * 1000);
		led &= ~LED1;	// clear bit
	}
	led &= 0xFC;	// 0b 1111 1100
	if (bri > 0.5)
		GPIOE->BSHR = led;	// assert
	else
		GPIOE->BCR = led;	// clear

}
