HUANsic/ICAR_Hover2024/CH32Code/ICAR_Hover2024_Master/OLED/OLED_Data_Hanzi.c

#include <OLED_Data.h>

/*汉字字模数据*********************/

/*相同的汉字只需要定义一次，汉字不分先后顺序*/
/*必须全部为汉字或者全角字符，不要加入任何半角字符*/

/*宽16像素，高16像素*/
const ChineseCell_t OLED_CF16x16[] = {
	
	
0x00,0x20,0x38,0xA6,0x60,0x18,0x00,0xF8,0x48,0x4A,0x4C,0x48,0x48,0x78,0x00,0x00,0x00,0x22,0x23,0x22,0x12,0x12,0x04,0x7F,0x09,0x3F,0x09,0x3F,0x49,0x7F,0x00,0x00,"编",//0
0x00,0x10,0x90,0xFE,0x90,0x50,0x44,0x44,0x44,0xC4,0x44,0x44,0x44,0x40,0x00,0x00,0x00,0x02,0x01,0x7F,0x00,0x11,0x0C,0x43,0x40,0x7F,0x00,0x01,0x06,0x18,0x00,0x00,"标",//1
0x00,0x40,0x84,0x08,0x10,0x00,0xF8,0x88,0x88,0x88,0xFE,0x88,0x88,0x38,0x00,0x00,0x00,0x00,0x30,0x0C,0x43,0x30,0x4F,0x40,0x23,0x2C,0x10,0x28,0x47,0x40,0x00,0x00,"波",//2
0x00,0x10,0x10,0xFE,0x10,0x08,0xE8,0x28,0x28,0xFE,0x28,0x2A,0xEC,0x08,0x00,0x00,0x00,0x42,0x42,0x7F,0x01,0x00,0x7F,0x09,0x09,0x3F,0x09,0x49,0x7F,0x00,0x00,0x00,"捕",//3
0x00,0x00,0x7C,0x40,0x40,0x40,0x40,0xFE,0x40,0x40,0x40,0x40,0x7C,0x00,0x00,0x00,0x00,0x3E,0x20,0x20,0x20,0x20,0x20,0x3F,0x20,0x20,0x20,0x20,0x20,0x7E,0x00,0x00,"出",//4
0x00,0x00,0x78,0x48,0x48,0x48,0x48,0xFE,0x48,0x48,0x48,0x48,0x78,0x00,0x00,0x00,0x00,0x1F,0x09,0x09,0x09,0x09,0x09,0x7F,0x09,0x09,0x09,0x09,0x09,0x1F,0x00,0x00,"串",//5
0x00,0x20,0x20,0x20,0x20,0x20,0xA0,0x7E,0xA0,0x20,0x20,0x20,0x20,0x20,0x00,0x00,0x00,0x40,0x40,0x20,0x10,0x0C,0x03,0x00,0x03,0x0C,0x10,0x20,0x40,0x40,0x00,0x00,"大",//6
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



/*未找到指定汉字时显示的默认图形（一个方框，内部一个问号），请确保其位于数组最末尾*/
0xFF,0x01,0x01,0x01,0x31,0x09,0x09,0x09,0x09,0x89,0x71,0x01,0x01,0x01,0x01,0xFF,
0xFF,0x80,0x80,0x80,0x80,0x80,0x80,0x96,0x81,0x80,0x80,0x80,0x80,0x80,0x80,0xFF,"",	
};

/*********************汉字字模数据*/
