HUANsic/ICAR_Hover2024/CH32Code/ICAR_Hover2024_Master/OLED/OLED_Data_Image.c

#include <OLED_Data.h>

/*图像数据*********************/
const uint8_t Cursor[] = {0x10,0x38,0x54,0x92,0x10,0x10,0x10,0x10,};

const uint8_t goutou[] = {
0xFF,0xFF,0xFF,0xFF,0xFF,0xFF,0x5F,0xF7,0xAB,0xFF,0xAF,0xDF,0xFF,0x3F,0xFF,0xBF,
0xDF,0xFF,0x5F,0xFF,0xBF,0xDF,0x6F,0xF7,0x9B,0xEF,0xB5,0x6B,0xBF,0xFF,0xFF,0xFF,
0xFF,0xFF,0x1F,0xE7,0xF9,0xCF,0xFF,0x0E,0x1F,0x0B,0x1E,0xBF,0xF5,0xAF,0x5F,0xDB,
0xEE,0xDF,0xEF,0xDD,0xEF,0x1B,0x0F,0x1E,0x1B,0xFE,0xF7,0x59,0xFF,0xAF,0xFF,0xFF,
0xFF,0xFF,0x57,0xFC,0xFF,0xFE,0xFD,0xBF,0x7A,0x92,0x82,0x33,0x79,0x7F,0x7F,0x3C,
0xBF,0xFE,0xFD,0xFA,0xFF,0xF6,0xFA,0xFE,0xF7,0xFD,0xFF,0x7D,0xBF,0xEA,0xFF,0xFF,
0xFF,0xFF,0xFF,0xFA,0xFF,0xEB,0xFF,0xF7,0xDF,0xEF,0xFF,0xDF,0xFF,0xDE,0xFF,0xDF,
0xFF,0xDF,0xBF,0xEF,0xDF,0xFF,0xE7,0xFF,0xF7,0xFB,0xFD,0xFF,0xFF,0xFF,0xFF,0xFF,
};

//壁纸
const uint8_t Wallpaper[] = {
 0xFF,0xFF,0xFF,0xFF,0xFF,0xFF,0xFF,0xFF,0xFF,0xFF,0xFF,0xFF,0xFF,0xFF,0xFF,0xFF ,
 0xFF,0xFF,0xFF,0xFF,0xFF,0xFF,0xFF,0xFF,0xFF,0xFF,0xFF,0xFF,0xFF,0xFF,0xFF,0xFF ,
 0xD7,0xAF,0xFF,0xED,0xBF,0xFF,0x7F,0xF5,0x9A,0x65,0x1A,0xF5,0x0B,0xF7,0x2C,0xD0 ,
 0xB0,0x50,0xA4,0xC0,0x60,0xF4,0xA0,0xF0,0xF0,0xB0,0xE8,0xF0,0x70,0xD0,0xB8,0xF0 ,
 0xB8,0xF0,0x58,0xF8,0xD8,0x7C,0xB0,0xE8,0xBC,0xD6,0x65,0xBD,0x42,0xBD,0x42,0x2D ,
 0x80,0x00,0x00,0x00,0x20,0x00,0x00,0x00,0x10,0x00,0x00,0x00,0x00,0x20,0x00,0x00 ,
 0xFF,0xFF,0xFF,0xFF,0xFF,0xFF,0xFF,0xFF,0xFF,0xFF,0xFF,0xFF,0xFF,0xFF,0xFF,0xFF ,
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
 0xF1,0x44,0xD1,0x04,0x40,0x14,0x01,0x44,0x10,0x82,0x08,0x41,0x10,0x04,0x41,0x08 ,
 0xFF,0xFF,0xFF,0xFF,0xFF,0xFF,0xFF,0xFF,0xFF,0xFF,0xFF,0xFF,0xFF,0xFF,0xFF,0xFF ,
 0xFF,0xFF,0xFF,0xFF,0xFF,0xFF,0xFF,0xFF,0xFF,0xFF,0xFF,0xFF,0xFF,0xFF,0xFF,0xFF ,
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
};

/*********************图像数据*/
