HUANsic/ICAR_Hover2024/CH32Code/ICAR_Hover2024_Master/User/huansic_util.h

/*
 * huansic_util.h
 *
 *  Created on: May 21, 2024
 *      Author: ZonghuanWu
 */

#ifndef USER_HUANSIC_UTIL_H_
#define USER_HUANSIC_UTIL_H_

#include "ch32v30x.h"

void util_init();

void util_led1_set(float bri);

void util_led2_set(float bri);

#endif /* USER_HUANSIC_UTIL_H_ */
