HUANsic/ICAR_Hover2024/(commit log)

2024-05-20 moved git repo to parent folder - now including all materials
    [3D_MiniDriver_2024-01-19.SLDPRT, 3D_MiniDriver_2024-01-19.step, BOM_Main_v2_Main_v2_2024-05-20.xlsx, BOM_MiniCore_MiniCore_2024-01-13.xlsx, BOM_MiniDriver_MiniDriver_2024-01-13.xlsx, BOM_MiniPower_MiniPower_2024-01-13.xlsx, Battery_322006.SLDPRT, Battery_372006.SLDPRT]
2024-07-02 added version3 PCB info and model; updated some code
    [BOM_Main_v2_Main_v2_2024-05-20.xlsx, BOM_Main_v2_Main_v2_2024-06-27.xlsx, PickAndPlace_Main_v2_2024-05-20.xlsx, PickAndPlace_Main_v2_2024-06-27.xlsx, base.SLDPRT, base.STL]
2024-07-02 fixed issues in huansic_chronos; tested and verified
    [huansic_ble.c, huansic_chronos.c, huansic_chronos.h, huansic_comm.c, main.c]
2024-07-02 add hardware and oled driver
2024-07-03 fixed bug in time wheel, tested and verified; added motor lib
    [ch32v30x.h, huansic_chronos.c, huansic_motor.c, huansic_motor.h, huansic_uitl.c, main.c]
2024-07-03 motor library completed, tested, and verified
2024-07-04 added serial communication between chips (tested) and opt sensor code (untested)
2024-07-05 Revert "Merge branch 'liaoy' into 'dev'"
    This reverts merge request !1
    [huansic_comm.c, huansic_comm.h, huansic_uitl.c, huansic_util.h, main.c, usart2.c, usart2.h]
2024-07-07 added models; adjusted gitignore
    [FanHolder.SLDPRT, FanHolder.STL, PropHolder1.SLDPRT, PropHolder1.STL, base.SLDPRT, fan1.gcode.3mf, prop1.gcode.3mf, support10mm.gcode.3mf]
2024-08-02 added version 3 of PCB and SW;attempted to seperate functions from master
    [716_1mm.SLDPRT, BOM_Main_v3_Main_v3_2024-07-28.xlsx, BOM_OV2640_CAM_OV2640_CAM_2024-07-28.xlsx, CF_stick_2x1x240.SLDPRT, CF_stick_2x1x300.SLDPRT, CameraBase.SLDPRT, CameraBase_1.STL, CameraBase_2.STL]
2024-08-11 added MT9V034 connector board
2024-08-12 fixed clock issue; utility-time calibrated
    [ch32v30x_conf.h, huansic_utility.c, huansic_utility.h, main.c]
